aspro648/Arduino/README.md

# Arduino
DIY Clones done in KiCAD

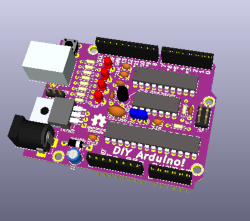
[picture p1: DIY Arduino/Arduino/images/project.png]
 
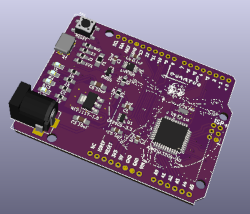
[picture p2: Leonardo/images/project.png]
 

- [Uno Compatible Through Hole](DIY%20Arduino/Arduino)
- [Leonardo Compatible Surface Mount](Leonardo/)
