aspro648/Arduino/DIY Arduino/20QFNtoDIP/project.png

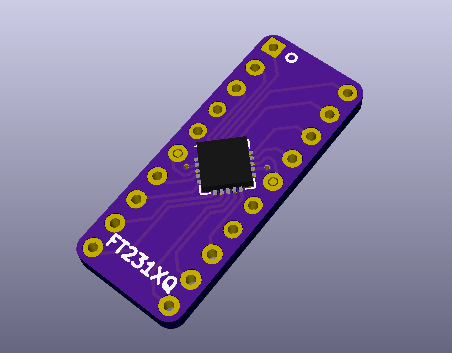
DIY Arduino/20QFNtoDIP/project.png
