aspro648/Arduino/DIY Arduino/Arduino/documents/DIYArduino Label.png

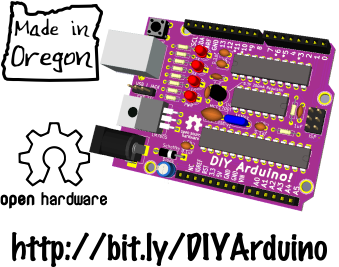
DIY Arduino/Arduino/documents/DIYArduino Label.png
