aspro648/Arduino/DIY Arduino/Arduino/images/2019-03-30T04_05_36.657Z-P1080907.JPG

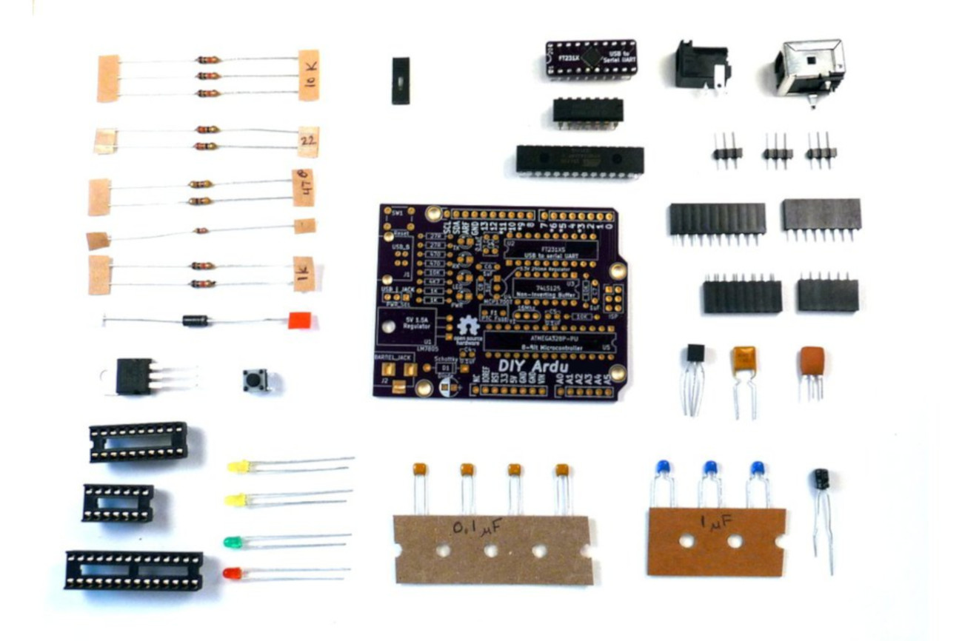
DIY Arduino/Arduino/images/2019-03-30T04_05_36.657Z-P1080907.JPG
