aspro648/Arduino/DIY Arduino/Arduino/images/Ardu.JPG

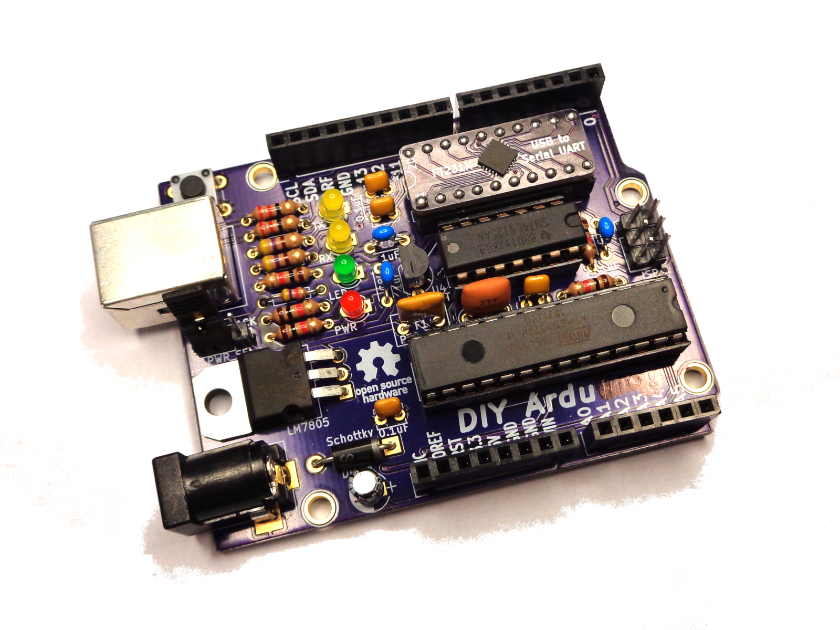
DIY Arduino/Arduino/images/Ardu.JPG
