aspro648/Arduino/DIY Arduino/Arduino/images/DIYArduino.png

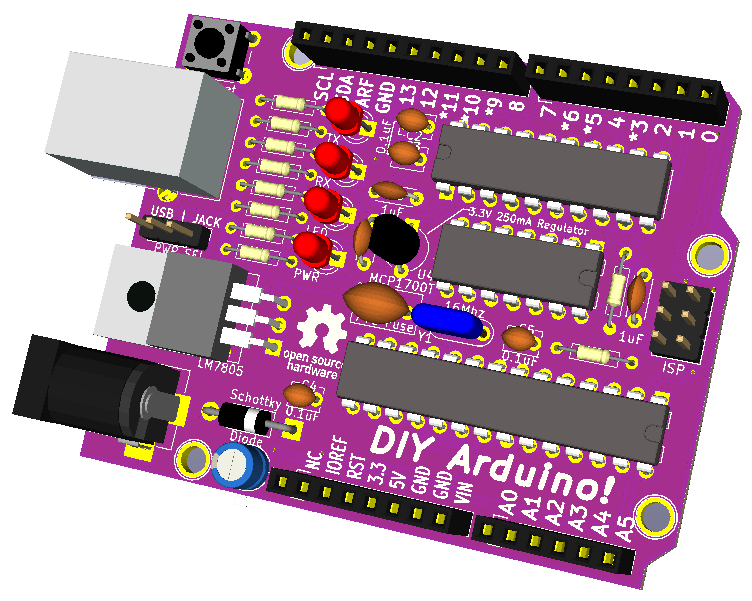
DIY Arduino/Arduino/images/DIYArduino.png
