aspro648/Arduino/Leonardo/documents/label.png

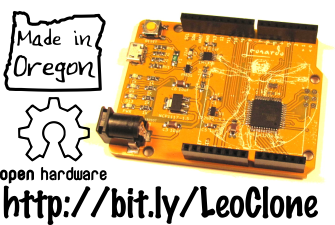
Leonardo/documents/label.png
