aspro648/Arduino/Leonardo/images/back.JPG

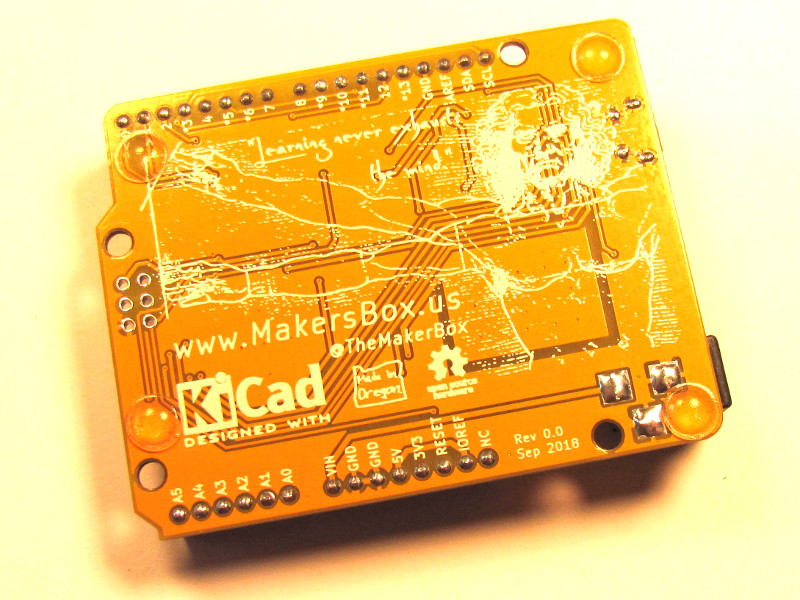
Leonardo/images/back.JPG
