aspro648/Arduino/Leonardo/images/Da_Vinci_Vitruve3.jpg

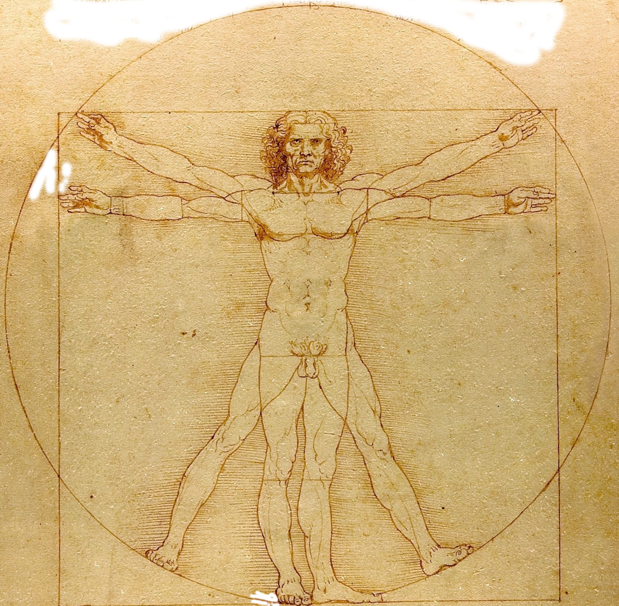
Leonardo/images/Da_Vinci_Vitruve3.jpg
