aspro648/Arduino/Leonardo/images/Da_Vinci_Vitruve_Luc_Viatour.jpg

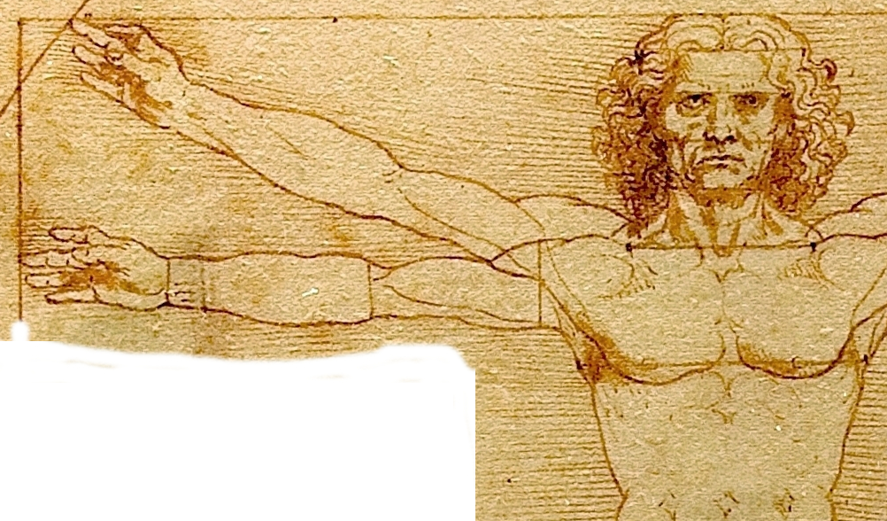
Leonardo/images/Da_Vinci_Vitruve_Luc_Viatour.jpg
