aspro648/Arduino/Leonardo/images/front.JPG

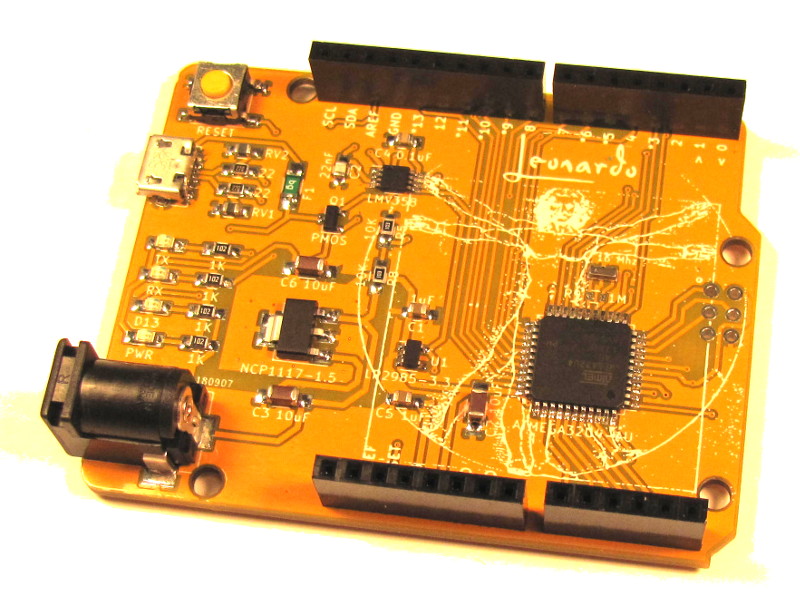
Leonardo/images/front.JPG
