aspro648/Arduino/Leonardo/images/IMG_0759.JPG

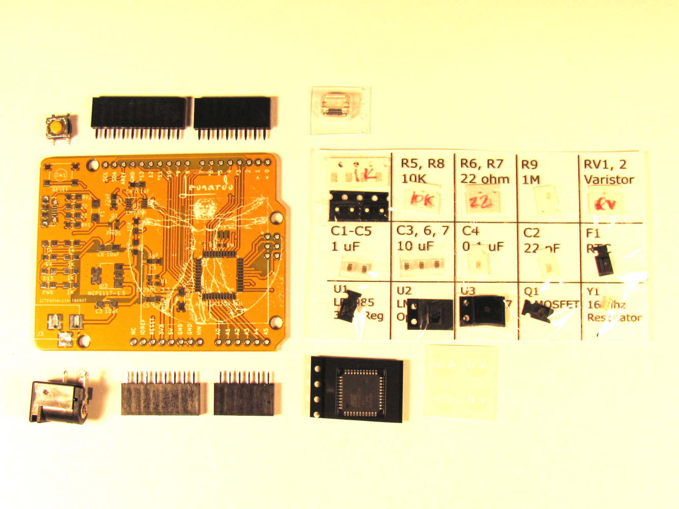
Leonardo/images/IMG_0759.JPG
