aspro648/Arduino/Leonardo/images/project_back.png

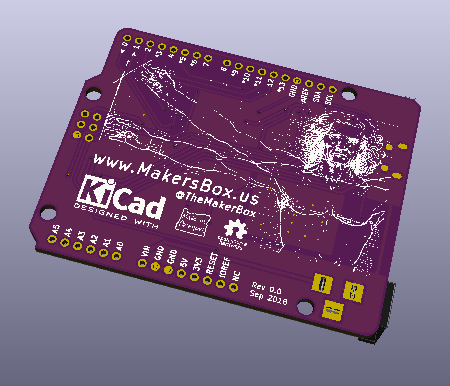
Leonardo/images/project_back.png
