aspro648/Arduino/Leonardo/images/quote.png

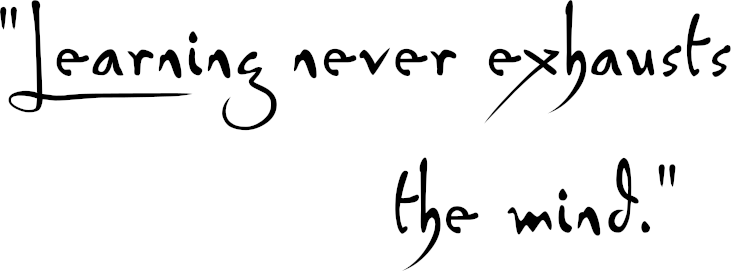
Leonardo/images/quote.png
