aspro648/Arduino/Leonardo/design_files/Bom.xlsx

Description | Manufacturer Part Number | Manufacturer | Digi-Key Part Number | Customer Reference | Quantity | $ at Qty 1 | $ at Qty 25 | Total @ Qty 1 | Tota @ Qty 25
PCB |  | OSH Park | - | - | 1 | $9.48 | $5.72 | $9.48 | $5.72 | ~$2.60 JLCPCB?
IC REG LINEAR 3.3V 150MA SOT23-5 | LP2985-33DBVRG4 | Texas Instruments | 296-49790-1-ND | Leo U1 | 1 | $0.60 | $0.53 | $0.60 | $0.53
IC OPAMP GP 1MHZ RRO 8VSSOP | LMV358IDGKR | Texas Instruments | 296-13455-1-ND | Leo U2 | 1 | $0.80 | $0.71 | $0.80 | $0.71
IC MCU 8BIT 32KB FLASH 44TQFP | ATMEGA32U4-AUR | Microchip Technology | ATMEGA32U4-AURCT-ND | Leo U4 | 1 | $4.20 | $3.85 | $4.20 | $3.85
IC REG LINEAR 5V 1A SOT223 | NCP1117ST50T3G | ON Semiconductor | NCP1117ST50T3GOSCT-ND | Leo U3 | 1 | $0.54 | $0.46 | $0.54 | $0.46
MOSFET P-CH 20V 2A SSOT3 | FDN340P | ON Semiconductor | FDN340PCT-ND | Leo Q1 | 1 | $0.55 | $0.43 | $0.55 | $0.43
CER RES 16.0000MHZ 15PF SMD | CSTCE16M0V53-R0 | Murata Electronics North America | 490-1198-1-ND | Leo Y1 | 1 | $0.50 | $0.42 | $0.50 | $0.42
CAP CER 10UF 35V X5R 1206 | GRM319R6YA106KA12D | Murata Electronics North America | 490-9964-1-ND | Leo C3, C6, C7 | 3 | $0.41 | $0.16 | $1.23 | $0.48
CAP CER 0.1UF 25V X7R 0805 | CC0805KRX7R8BB104 | Yageo | 311-1141-1-ND | Leo C4 | 1 | $0.13 | $0.10 | $0.13 | $0.10
CAP CER 22PF 25V C0G/NP0 0805 | 885012007030 | Wurth Electronics Inc. | 732-7829-1-ND | Leo C2 | 1 | $0.10 | $0.05 | $0.10 | $0.05
CAP CER 1UF 25V X5R 0805 | CL21A105KAFNNNE | Samsung Electro-Mechanics | 1276-2887-1-ND | Leo C1, C5 | 2 | $0.19 | $0.14 | $0.38 | $0.28
PTC RESET FUSE 24V 250MA 1206 | 0ZCJ0025AF2E | Bel Fuse Inc. | 507-1799-1-ND | Leo F1 | 1 | $0.13 | $0.13 | $0.13 | $0.13
VARISTOR 10.8V 40A 0805 | VCUG080050L1DP | AVX Corporation | 478-5584-1-ND | Leo RV1, RV2 | 2 | $0.49 | $0.36 | $0.98 | $0.72
RES SMD 1K OHM 5% 1/8W 0805 | ERJ-6GEYJ102V | Panasonic Electronic Components | P1.0KACT-ND | Leo R1 - R4 | 4 | $0.10 | $0.03 | $0.40 | $0.12
RES SMD 10K OHM 5% 1/8W 0805 | ERJ-6GEYJ103V | Panasonic Electronic Components | P10KACT-ND | Leo R5, R8 | 2 | $0.10 | $0.03 | $0.20 | $0.06
RES SMD 22 OHM 5% 0.4W 0805 | ESR10EZPJ220 | Rohm Semiconductor | RHM22KCT-ND | Leo R6, R7 | 2 | $0.10 | $0.03 | $0.20 | $0.06
CRGCQ 0603 1M0 5% | CRGCQ0603J1M0 | TE Connectivity Passive Product | A130109CT-ND | Leo R9 | 1 | $0.10 | $0.03 | $0.10 | $0.03
LED ORANGE CLEAR SMD | LTST-C170KFKT | Lite-On Inc. | 160-1413-1-ND | Leo D1-D4 | 4 | $0.31 | $0.12 | $1.24 | $0.48
SWITCH TACTILE SPST-NO 0.05A 24V | B3S-1002 | Omron Electronics Inc-EMC Div | SW416-ND | Leo SW1 | 1 | $0.66 | $0.62 | $0.66 | $0.62
CONN RCPT MICRO USB R/A SMD | 1050170001 | Molex, LLC | WM1399CT-ND | Leo X3 | 1 | $0.87 | $0.72 | $0.87 | $0.72
CONN PWR JACK 2X5.5MM SOLDER | PJ-002A | CUI Inc. | CP-002A-ND | Leo J1 | 1 | $0.61 | $0.52 | $0.61 | $0.52
CONN HEADER FEMALE 6POS .1" TIN | PPTC061LFBN-RC | Sullins Connector Solutions | S7004-ND | Leo | 1 | $0.52 | $0.48 | $0.52 | $0.48
CONN HEADER FEMALE 8POS .1" TIN | PPTC081LFBN-RC | Sullins Connector Solutions | S7006-ND | Leo | 2 | $0.65 | $0.61 | $1.30 | $1.22
CONN HEADER FEMALE 10POS.1" TIN | PPTC101LFBN-RC | Sullins Connector Solutions | S7008-ND | Leo | 1 | $0.65 | $0.57 | $0.65 | $0.57
 |  |  |  |  |  |  |  | $26.37 | $18.76
