aspro648/Arduino/DIY Arduino/Arduino/documents/NerO BOM List.xls

Sheet: Bill of Materials
Bill of Materials for: |  | Bill of Materials For Project HW_459_Long Pin |  |  |  |  | Future Technology Devices International Ltd.
 |  | Inspired by Arduino UNO R3 |  |  |  |  | Unit 1, 2 Seaward Place,
 |  |  |  |  |  |  | Centurion Business Park
 | Source Data From: | HW_459.PrjPcb |  |  |  |  | Glasgow, G411HH
 | Project: | HW_459.PrjPcb |  |  |  |  | Tel. +44 (0) 141 429 2777
 | Variant: | None |  |  |  |  | www.ftdichip.com
 | Revision: | 1.1
 | Report Date: | 4/1/2016 | 5:01:35 PM
# | Designator | Comment | Description | Footprint | Quantity | DigiKeyPartNo | ManufacturerPartNo | Manufacturer | Note
1 | C3, C4, C5, C7, C9, C11, C12, C14, C16, C19, C20, C21, C22 | 0.1UF | Capacitor bipolar | CAPC1608-0603 | 13 | 1276-1936-1-ND | CL10B104KB8SFNC | Samsung Electro-Mechanics America, Inc. | CAP CERAMIC .1UF 50V X7R 0603
2 | C6, C8, C13, C23 | 10uF | Polarized Capacitor | CAPM-A-3216-18 | 4 | 478-1657-1-ND | TAJA106M010RNJ | AVX Corporation | CAP TANT LOESR 10.0UF 10V 20% SMD 1206
3 | C10 | 10UF/25V | Polarized Capacitor | CAPM-B-3528-21 | 1 | 478-8887-1-ND | TAJB106M025RNJ | AVX Corporation | CAP TANT 10UF 25V 20% 1210
4 | C15 | 1NF | Capacitor bipolar | CAPC1608-0603 | 1 | 1276-1916-1-ND | CL10B102KB8SFNC | Samsung Electro-Mechanics America, Inc. | CAP 1000PF 50V CERAMIC X7R 0603
5 | C17, C18 | 15pF | Capacitor bipolar | CAPC1608-0603 | 2 | 1276-1296-1-ND | CL10C150JB8NNNC | Samsung Electro-Mechanics America, Inc. | CAP CER 15PF 50V 5% NPO 0603
6 | C24 | 10nF | Capacitor bipolar | CAPC1608-0603 | 1 | 1276-1927-1-ND | CL10B103MB8NCNC | Samsung Electro-Mechanics America, Inc. | CAP CER 10000PF 50V X7R 0603
7 | CN1 | CN USB | Mini USB connector; SMD | CN_USB_MICRO_HOUSING | 1 | --- | MIC5-5BF1-KNM1-23 | E-CONN ELECTRONIC(SU-ZHOU) CO., LTD | MICRO USB B REC. (HOUSEING HOLE)
8 | CN2 | 2.1mm PwrJack | Low Voltage Power Supply Connector | CN_2.1mm Power Socket routed pins | 1 | CP-002A-ND | PJ-002A | CUI Inc | CONN POWER JACK 2.1MM
9 | CN3 | TC2030-IDC-FP | ISP Connector, 6-Pin, Dual row, pitch 0.05"; Tag-Connect; TC2030-IDC-FP | CN_HDR2X3 | 1 | S2011E-03-ND | PBC03DAAN | Sullins Connector Solutions | CONN HEADER .100 DUAL STR 6POS
10 | CN4, CN7 | HEADER 8 | Header, 8-Pin | CN_HDR1X8 | 2 |  | FAS1851-0801A03XABXA | JunJia Electronics Technology | Connector Receptacle 8 Position 0.100" (2.54mm) Tin Through Hole
11 | CN5 | HEADER 10 | Header, 10-Pin | CN_HDR1X10 | 1 |  | FAS1851-1001A03XABXA | JunJia Electronics Technology | Connector Receptacle 10 Position 0.100" (2.54mm) Tin Through Hole
12 | CN6 | HEADER 6 | Header, 6-Pin | HDR1X6 | 1 |  | FAS1851-0601A03XABXA | JunJia Electronics Technology | Connector Receptacle 6 Position 0.100" (2.54mm) Tin Through Hole
13 | D1, D3 | MSS1P3L | Zener Diode | DIODE_MSS1P3L | 2 | MSS1P3L-M3/89AGICT-ND | MSS1P3L | VISHAY SEMICONDUCTOR | DIODE SCHOTTKY 30V 1A MICROSMP
14 | D2, D4 | 1N4148 | DIODE SWITCH 75V 200MW SOD323 | SOD-323 | 2 | 1N4148WS-FDICT-ND | 1N4148WS-7-F | Diodes Inc | DIODE SWITCH 75V 200MW SOD323
15 | F1 | 1.1A | Fuse | Fuse_0ZCG Series | 1 | 507-1767-1-ND | 0ZCG0110AF2C | Bel Fuse Inc | PTC RESTTBLE 1.10A 16V CHIP 1812
16 | FB1, FB2 | 600R/2A | Chip Ferrite Bead 0805 | IND_C2012-0805 | 2 | 445-2206-1-ND | MPZ2012S601A | TDK Corporation | FERRITE CHIP 600 OHM 2A 0805
17 | L1 | 22UH | Magnetic-Core Inductor | IND_NR6020 | 1 | 587-2103-1-ND | NR6028T220M | TAIYO YUDEN | IND 22UH 1.4A +-20% 6X6X2.8MM
18 | PCB | HW_459 Rev1.1 Bare PCB |  |  | 1 |  |  |  | HW_459 Rev1.1 Bare PCB
19 | PWR | Green | Typical LED diode | LEDC2012-0805 | 1 | 160-1179-1-ND | LTST-C170GKT | Lite-On Inc | LED GREEN CLEAR 0805 SMD
20 | Q1, Q2 | IRLM6402PBF | P-Channel MOSFET; SOT-23 | SOT23-3AL | 2 | IRLML6402PBFCT-ND | IRLML6402TRPBF | International Rectifier | MOSFET P-CH 20V 3.7A SOT-23
21 | R1, R2 | 27R | Resistor | RESC1608-0603 | 2 |  | 0603WGF0270 | UniOhm | RES 27R OHM 1/16W 1% 0603 SMD
22 | R3, R4 | 470R | Resistor | RESC1608-0603 | 2 |  | 0603WGJ0471 | UniOhm | RES 470 OHM 5% 1/16W 0603 SMD
23 | R6, R7, R15, R22 | 1K | Resistor | RESC1608-0603 | 4 |  | 0603WGJ0102 | UniOhm | RES 1K OHM 1/16W 5% 0603 SMD
24 | R9, R12, R13, R19 | 47K | Resistor | RESC1608-0603 | 4 |  | 0603WGJ0473 | UniOhm | RES 47K OHM 1/16W 5% 0603 SMD
25 | R10 | 47K5 | Resistor | RESC1608-0603 | 1 |  | 0603WGF4752 | UniOhm | RES 47K5 OHM 1/16W 1% 0603 SMD
26 | R11 | 9K1 | Resistor | RESC1608-0603 | 1 |  | 0603WGF0912 | UniOhm | RES 9K1 OHM 1% 1/16W 0603 SMD
27 | R14, R21, R23 | 10K | Resistor | RESC1608-0603 | 3 |  | 0603WGF0103 | UniOhm | RES 10K OHM 1/16W 1% 0603 SMD
28 | R17 | 0R | Resistor | RESC1608-0603 | 1 |  | 0603WAF0000XXX | UniOhm | RES 0 OHM 1/16W 0603 SMD
29 | R20 | 4K7 | Resistor | RESC1608-0603 | 1 |  | 0603WGF0472 | UniOhm | RES 4K7 OHM 1% 1/16W 0603 SMD
30 | RX, TX | Yellow | Typical LED diode | LEDC2012-0805 | 2 | 160-1175-1-ND | LTST-C170YKT | Lite-On Inc | LED YELLOW CLEAR 0805 SMD
31 | SCK | Red | Typical LED diode | LEDC2012-0805 | 1 | L61101CT-ND | 7012X1 | Chicago Miniature Lighting, LLC | LED RED CLEAR 0805 SMD
32 | SW1 | SW-DPDT | SPDT Switch | SW_JS202011AQN | 1 | 401-2000-ND | JS202011AQN | C&K Components | SWITCH SLIDE DPDT 300MA 6V
33 | SW2 | SW_PB | Push button momentary switch | SW_PushButton | 1 | 450-1650-ND | 1825910-6 | TE Connectivity Alcoswitch Switches | SWITCH TACTILE SPST-NO 0.05A 24V
34 | U1 | FT231XS | FT231XS-SSOP-20 | SSOP20 | 1 | 768-1129-1-ND | FT231XS-R | FTDI chip | IC USB SERIAL FULL UART 20SSOP
35 | U2, U6, U7 | CAHCT1G125QDCKRQ1 | IC BUS BUFF GATE 3ST SGL SC70-5 | SC70-5 | 3 | 296-29588-1-ND | CAHCT1G125QDCKRQ1 | Texas Instruments | Do not change to other vendor
36 | U3 | SPX3819M5-L-3-3/TR | 500mA, Low Dropout Linear Regulator with Shutdown | SOT23-5AL | 1 | 1016-1873-1-ND | SPX3819M5-L-3-3/TR | Exar Corporation | IC REG LDO 3.3V 0.5A SOT23-5
37 | U4 | AOZ1282CI | IC REG BUCK ADJ 1.2A SOT23-6 | SOT23-6N | 1 | 785-1613-1-ND | AOZ1282CI | ALPHA&OMEGA SEMICONDUCTOR | IC REG BUCK ADJ 1.2A SOT23-6
38 | U5 | ATMEGA328P-AU | IC MCU 8BIT 32KB FLASH 32TQFP | TQFP80P900X900X160-32N | 1 | ATMEGA328P-AURCT-ND | ATMEGA328P-AU | ATMEL | IC MCU 8BIT 32KB FLASH 32TQFP
39 | X1 | 16MHZ | Crystal Oscillator | CRYSTAL_16MHZ | 1 | 490-1198-1-ND | CSTCE16M0V53-R0 | Murata Electronic | CER RESONATOR 16.0MHZ SMD
Notes: |  |  |  | Components Count: | 73

Sheet: Project Information
Project Full Path | Z:\Hardware\PCB Designs\HW_459_NerO\Rev 1.1\HW_459.PrjPcb
Project Filename | HW_459.PrjPcb
Variant Name | None
Data-Source Filename | HW_459.PrjPcb
Data-Source Full Path | Z:\Hardware\PCB Designs\HW_459_NerO\Rev 1.1\HW_459.PrjPcb
Title | Bill of Materials For Project [HW_459.PrjPcb] (No PCB Document Selected)
Total Quantity | 73
Report Time | 5:01:35 PM
Report Date | 4/1/2016
Report Date & Tine | 4/1/2016 5:01:35 PM
Output Name | Bill of Materials
Output Type | BOM_PartType
Output Generator Name | BOM
Output Generator Description | Bill of Materials
