aspro648/Arduino/Leonardo/documents/parts.png

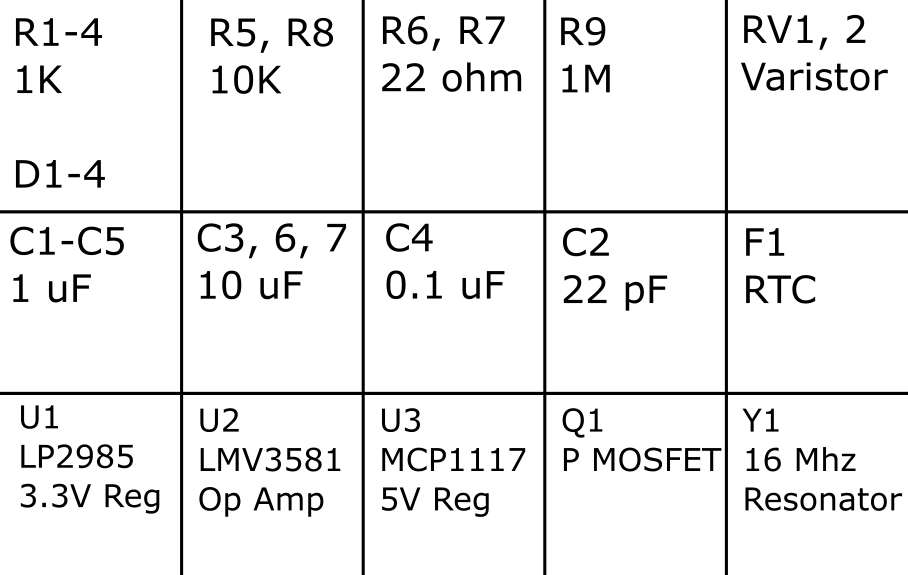
Leonardo/documents/parts.png
