aspro648/Arduino/DIY Arduino/Arduino/design_files/Arduino.kicad_pcb

## KiCad design DIY Arduino/Arduino/design_files/Arduino.kicad_pcb (2020-08-26)

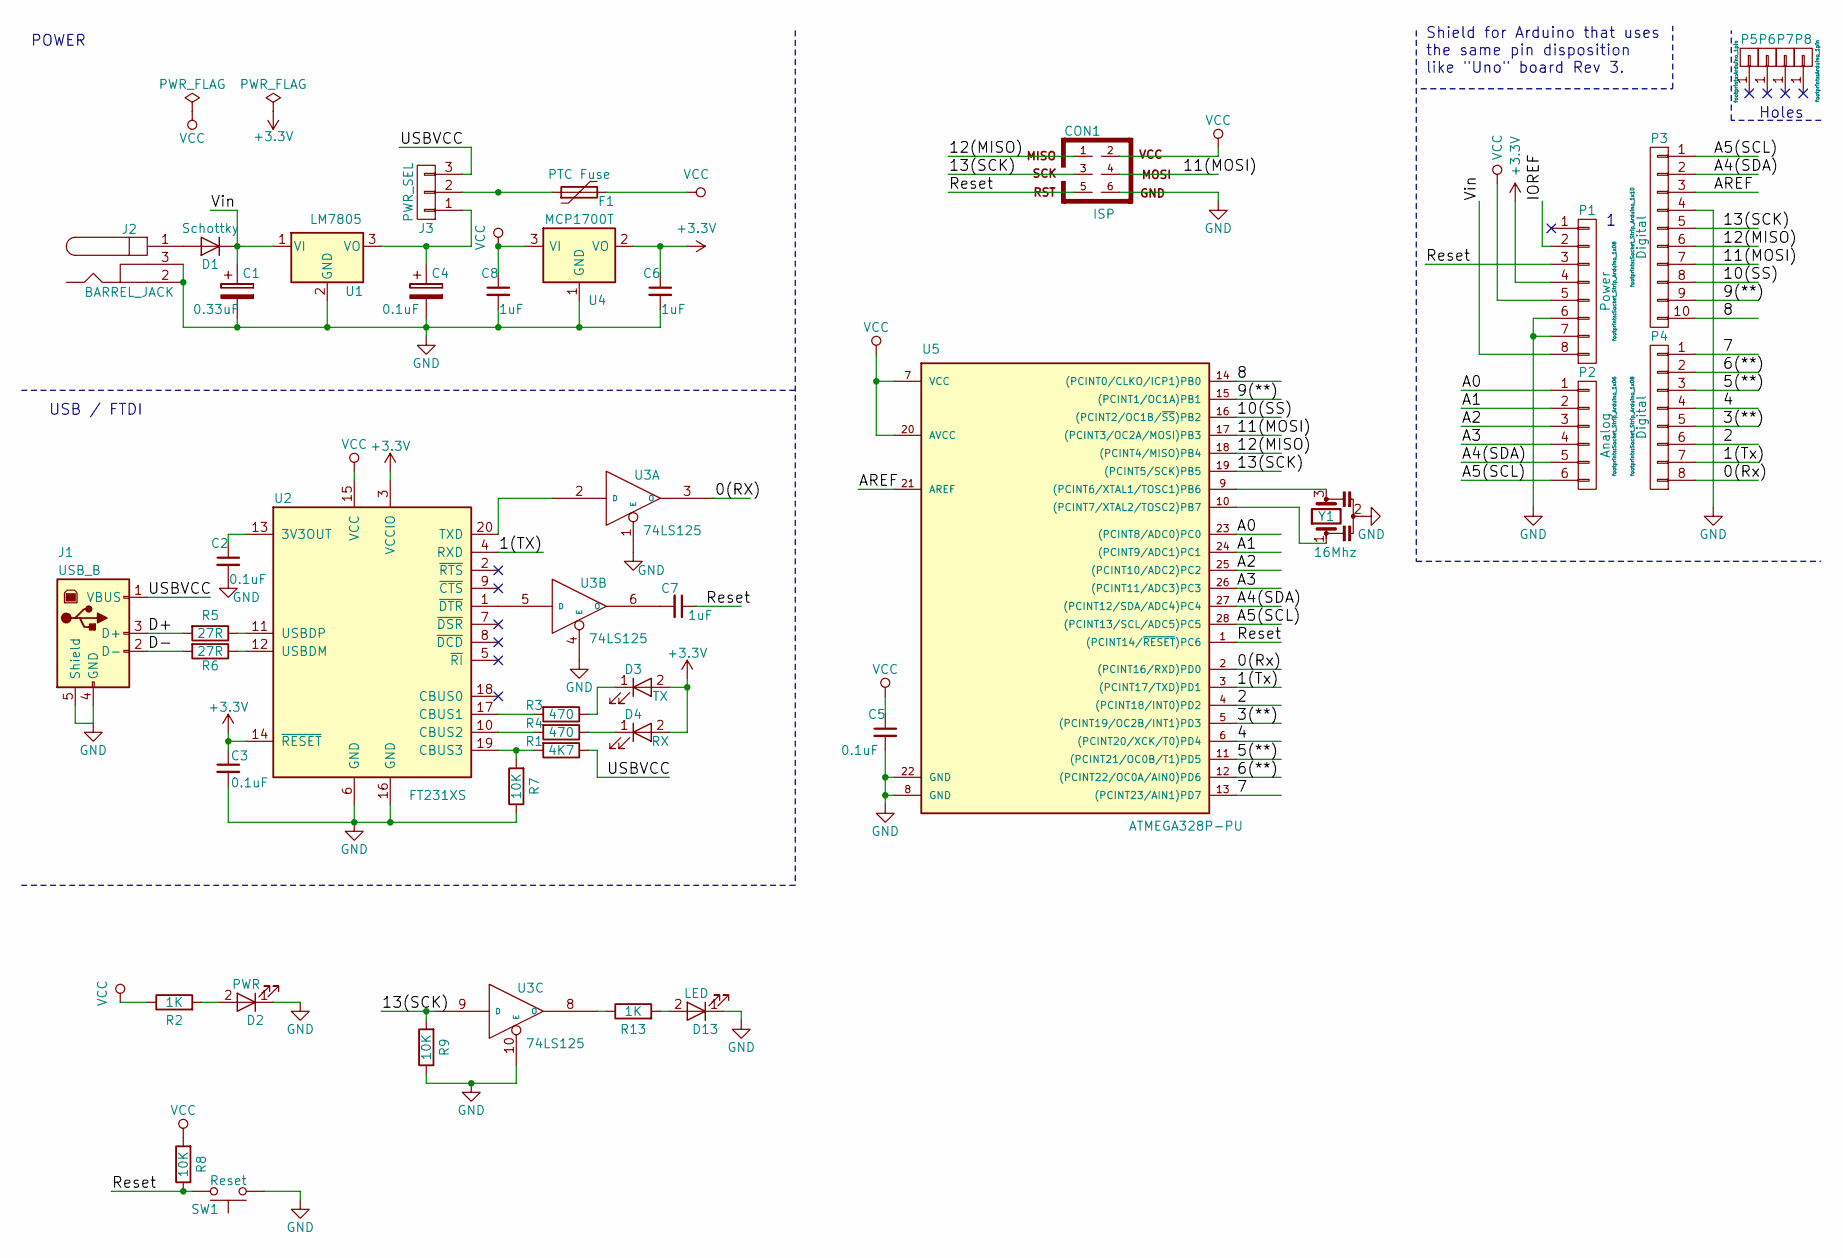
[picture p17: schematic Arduino.sch, DIY Arduino]

Parts:
C1: 0.33uF; CP_Radial_D4.0mm_P1.50mm
C2, C3, C4, C5: 0.1uF; C_Disc_D3.8mm_W2.6mm_P2.50mm
C6, C7, C8: 1uF; C_Disc_D4.3mm_W1.9mm_P5.00mm
CON1: ISP; Pin_Header_Straight_2x03_Pitch2.54mm
D1: Schottky; D_DO-41_SOD81_P10.16mm_Horizontal
D2: PWR; LED_D3.0mm
D3: TX; LED_D3.0mm
D4: RX; LED_D3.0mm
D13: LED; LED_D3.0mm
F1: PTC Fuse; C_Disc_D7.5mm_W4.4mm_P5.00mm
J1: USB_B
J2: BARREL_JACK
J3: PWR_SEL; Pin_Header_Straight_1x03_Pitch2.54mm
P1: Power; Socket_Strip_Arduino_1x08
P2: Analog; Socket_Strip_Arduino_1x06
P3: Digital; Socket_Strip_Arduino_1x10
P4: Digital; Socket_Strip_Arduino_1x08
P5, P6, P7, P8: CONN_01X01; Arduino_1pin
R1: 4K7; R_Axial_DIN0204_L3.6mm_D1.6mm_P7.62mm_Horizontal
R2, R13: 1K; R_Axial_DIN0204_L3.6mm_D1.6mm_P7.62mm_Horizontal
R3, R4: 470; R_Axial_DIN0204_L3.6mm_D1.6mm_P7.62mm_Horizontal
R5, R6: 27R; R_Axial_DIN0204_L3.6mm_D1.6mm_P7.62mm_Horizontal
R7, R8, R9: 10K; R_Axial_DIN0204_L3.6mm_D1.6mm_P7.62mm_Horizontal
SW1: Reset; SW_PUSH_6mm
U1: LM7805; TO-220-3_Horizontal
U2: FT231XS; DIP-20_W7.62mm
U3: 74LS125; DIP-14_W7.62mm
U4: MCP1700T; TO-92_Inline_Wide
U5: ATMEGA328P-PU; DIP-28_W7.62mm
Y1: 16Mhz; Resonator-3pin_w7.0mm_h2.5mm

Connections:
+3V3: C3.1, C6.1, D3.2 (A), D4.2 (A), P1.4, U2.3 (VCCIO), U2.14 (~RESET), U4.2 (VO)
/0(RX): P4.8, U3.3 (O), U5.2 ((PCINT16/RXD)PD0)
/1(TX): P4.7, U2.4 (RXD), U5.3 ((PCINT17/TXD)PD1)
/2: P4.6, U5.4 ((PCINT18/INT0)PD2)
/3(**): P4.5, U5.5 ((PCINT19/OC2B/INT1)PD3)
/4: P4.4, U5.6 ((PCINT20/XCK/T0)PD4)
/5(**): P4.3, U5.11 ((PCINT21/OC0B/T1)PD5)
/6(**): P4.2, U5.12 ((PCINT22/OC0A/AIN0)PD6)
/7: P4.1, U5.13 ((PCINT23/AIN1)PD7)
/8: P3.10, U5.14 ((PCINT0/CLKO/ICP1)PB0)
/9(**): P3.9, U5.15 ((PCINT1/OC1A)PB1)
/10(SS): P3.8, U5.16 ((PCINT2/OC1B/~SS~)PB2)
/11(MOSI): CON1.4, P3.7, U5.17 ((PCINT3/OC2A/MOSI)PB3)
/12(MISO): CON1.1, P3.6, U5.18 ((PCINT4/MISO)PB4)
/13(SCK): CON1.3, P3.5, R9.2, U3.9 (D), U5.19 ((PCINT5/SCK)PB5)
/A0: P2.1, U5.23 ((PCINT8/ADC0)PC0)
/A1: P2.2, U5.24 ((PCINT9/ADC1)PC1)
/A2: P2.3, U5.25 ((PCINT10/ADC2)PC2)
/A3: P2.4, U5.26 ((PCINT11/ADC3)PC3)
/A4(SDA): P2.5, P3.2, U5.27 ((PCINT12/SDA/ADC4)PC4)
/A5(SCL): P2.6, P3.1, U5.28 ((PCINT13/SCL/ADC5)PC5)
/AREF: P3.3, U5.21 (AREF)
/D+: J1.3 (D+), R5.2
/D-: J1.2 (D-), R6.2
/IOREF: P1.2
/Reset: C7.1, CON1.5, P1.3, R8.1, SW1.2, U5.1 ((PCINT14/~RESET~)PC6)
/USBVCC: J1.1 (VBUS), J3.3, R1.1
/Vin: C1.1, D1.1 (K), P1.8, U1.1 (VI)
GND: C1.2, C2.2, C3.2, C4.2, C5.2, C6.2, C8.2, CON1.6, D2.1 (K), D13.1 (K), J1.4 (GND), J1.5 (Shield), J2.2, J2.3, P1.6, P1.7, P3.4, R7.1, R9.1, SW1.1, U1.2 (GND), U2.6 (GND), U2.16 (GND), U3.1 (E), U3.4 (E), U3.7 (GND), U3.10 (E), U4.1 (GND), U5.8 (GND), U5.22 (GND), Y1.2
unnamed: C2.1, U2.13 (3V3OUT)
unnamed: C4.1, J3.1, U1.3 (VO)
unnamed: C7.2, U3.6 (O)
unnamed: D1.2 (A), J2.1
unnamed: D2.2 (A), R2.2
unnamed: D3.1 (K), R3.1
unnamed: D4.1 (K), R4.1
unnamed: D13.2 (A), R13.2
unnamed: F1.1, J3.2
unnamed: R1.2, R7.2, U2.19 (CBUS3)
unnamed: R3.2, U2.17 (CBUS1)
unnamed: R4.2, U2.10 (CBUS2)
unnamed: R5.1, U2.11 (USBDP)
unnamed: R6.1, U2.12 (USBDM)
unnamed: R13.1, U3.8 (O)
unnamed: U2.1 (~DTR), U3.5 (D)
unnamed: U2.20 (TXD), U3.2 (D)
unnamed: U5.9 ((PCINT6/XTAL1/TOSC1)PB6), Y1.3
unnamed: U5.10 ((PCINT7/XTAL2/TOSC2)PB7), Y1.1
VCC: C5.1, C8.1, CON1.2, F1.2, P1.5, R2.1, R8.2, U2.15 (VCC), U3.14 (VCC), U4.3 (VI), U5.7 (VCC), U5.20 (AVCC)

Notes on the sheet:
Holes
Shield for Arduino that uses the same pin disposition like "Uno" board Rev 3.
POWER
USB / FTDI

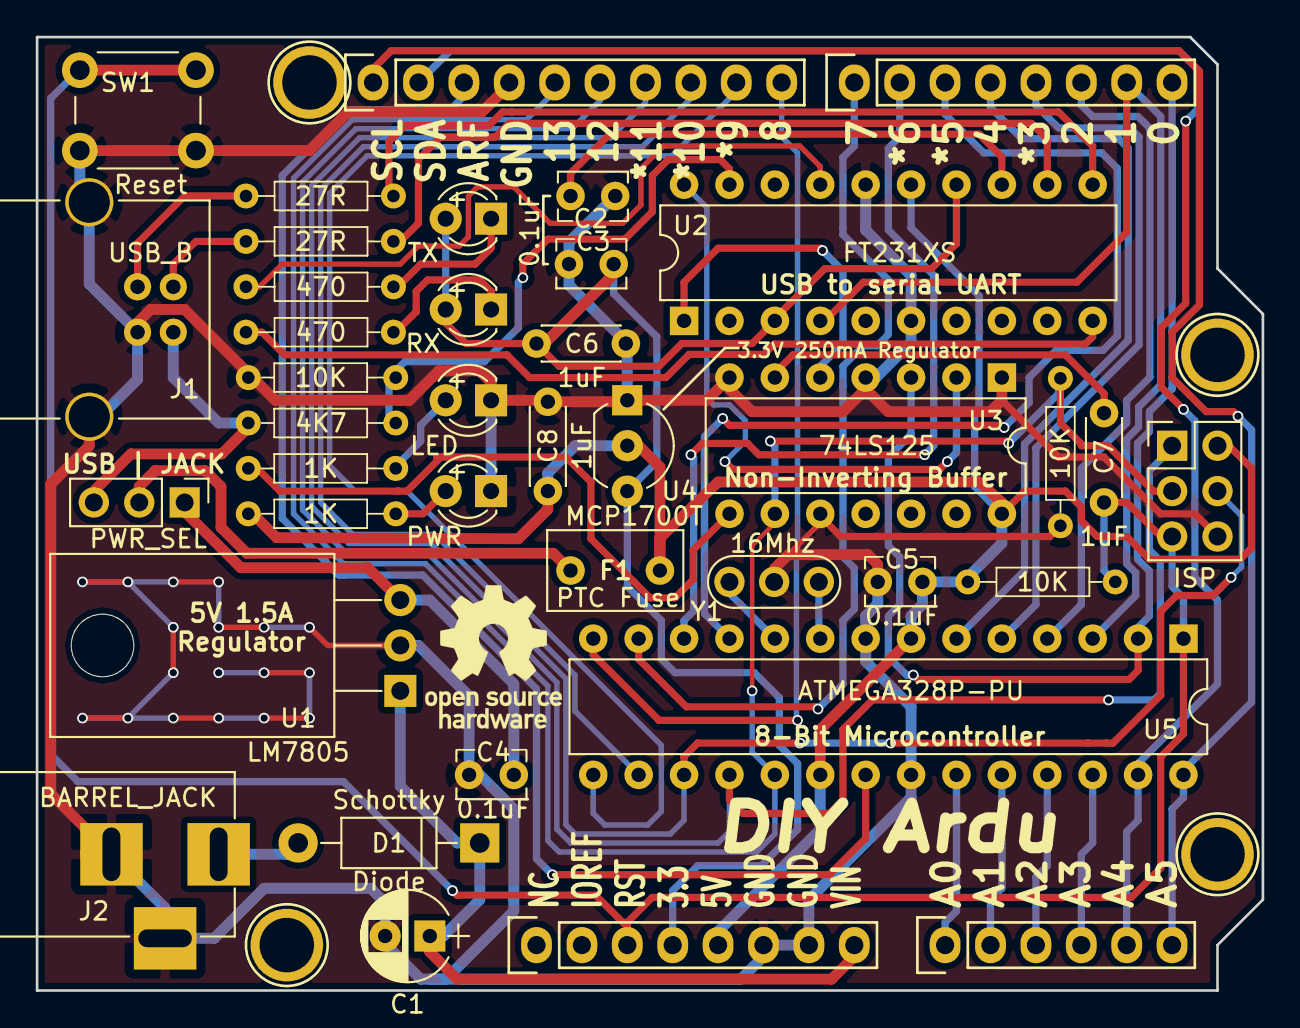
[picture p18: board Arduino.kicad_pcb from above]

Board: 2 copper layers, 68.6 x 53.3 mm, 43 parts (0 on the bottom side), 48 nets.
