aspro648/Arduino/Leonardo/design_files/project.kicad_pcb

## KiCad design Leonardo/design_files/project.kicad_pcb (2018-10-31)

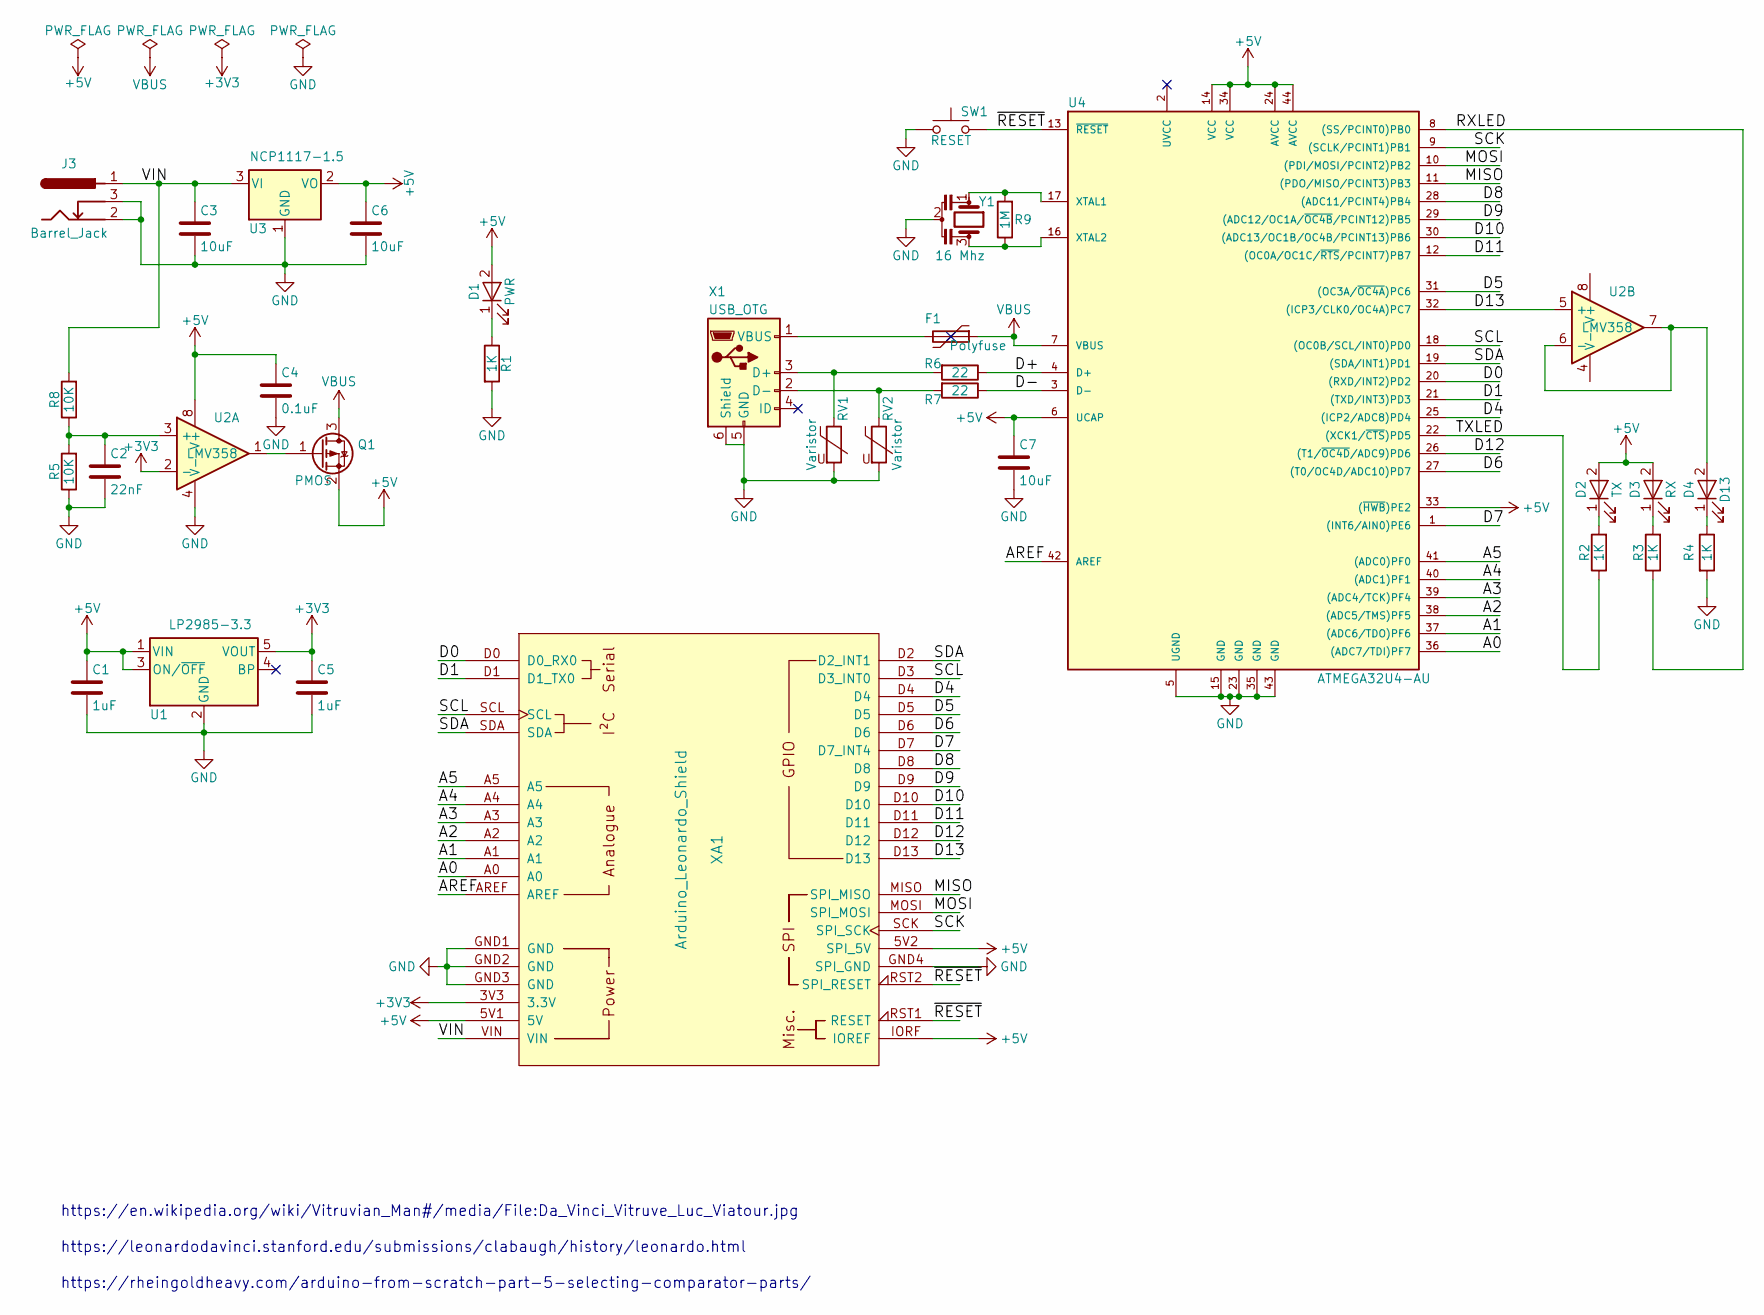
[picture p19: schematic project.sch, Leonardo 324U]

Parts:
C1, C5: 1uF; C_0805_HandSoldering
C2: 22nF; C_0805_HandSoldering
C3, C6, C7: 10uF; C_1206_HandSoldering
C4: 0.1uF; C_0805_HandSoldering
D1: PWR; LED_0805_HandSoldering
D2: TX; LED_0805_HandSoldering
D3: RX; LED_0805_HandSoldering
D4: D13; LED_0805_HandSoldering
F1: Polyfuse; R_1206_HandSoldering
J3: Barrel_Jack; BARREL_JACK
Q1: PMOS; SOT-23
R1, R2, R3, R4: 1K; R_0805_HandSoldering
R5, R8: 10K; R_0805_HandSoldering
R6, R7: 22; R_0805_HandSoldering
R9: 1M; R_0805_HandSoldering
RV1, RV2: Varistor; R_0805_HandSoldering
SW1: RESET; SW_SPST_PTS645
U1: LP2985-3.3; SOT-23-5
U2: LMV358; VSSOP-8_3.0x3.0mm_Pitch0.65mm
U3: NCP1117-1.5; SOT-223-3_TabPin2
U4: ATMEGA32U4-AU; TQFP-44_10x10mm_Pitch0.8mm
X1: USB_OTG; USB_Micro-B_Molex-105017-0001
XA1: Arduino_Leonardo_Shield
Y1: 16 Mhz; Resonator_SMD_CTSC_1.3mmx3.2mm

Connections:
+3V3: C5.1, U1.5 (VOUT), U2.2 (-), XA1.3V3 (3.3V)
+5V: C1.1, C4.1, C6.1, C7.1, D1.2 (A), D2.2 (A), D3.2 (A), Q1.2 (S), U1.1 (VIN), U1.3 (ON/~OFF~), U2.8 (V+), U3.2 (VO), U4.6 (UCAP), U4.14 (VCC), U4.24 (AVCC), U4.33 ((~HWB~)PE2), U4.34 (VCC), U4.44 (AVCC), XA1.5V1 (5V), XA1.5V2 (SPI_5V), XA1.IORF (IOREF)
/A0: U4.36 ((ADC7/TDI)PF7), XA1.A0
/A1: U4.37 ((ADC6/TDO)PF6), XA1.A1
/A2: U4.38 ((ADC5/TMS)PF5), XA1.A2
/A3: U4.39 ((ADC4/TCK)PF4), XA1.A3
/A4: U4.40 ((ADC1)PF1), XA1.A4
/A5: U4.41 ((ADC0)PF0), XA1.A5
/AREF: U4.42 (AREF), XA1.AREF
/D0: U4.20 ((RXD/INT2)PD2), XA1.D0 (D0_RX0)
/D1: U4.21 ((TXD/INT3)PD3), XA1.D1 (D1_TX0)
/D4: U4.25 ((ICP2/ADC8)PD4), XA1.D4
/D5: U4.31 ((OC3A/~OC4A~)PC6), XA1.D5
/D6: U4.27 ((T0/OC4D/ADC10)PD7), XA1.D6
/D7: U4.1 ((INT6/AIN0)PE6), XA1.D7 (D7_INT4)
/D8: U4.28 ((ADC11/PCINT4)PB4), XA1.D8
/D9: U4.29 ((ADC12/OC1A/~OC4B~/PCINT12)PB5), XA1.D9
/D10: U4.30 ((ADC13/OC1B/OC4B/PCINT13)PB6), XA1.D10
/D11: U4.12 ((OC0A/OC1C/~RTS~/PCINT7)PB7), XA1.D11
/D12: U4.26 ((T1/~OC4D~/ADC9)PD6), XA1.D12
/D13: U2.5 (+), U4.32 ((ICP3/CLK0/OC4A)PC7), XA1.D13
/D+: R6.1, U4.4 (D+)
/D-: R7.1, U4.3 (D-)
/MISO: U4.11 ((PDO/MISO/PCINT3)PB3), XA1.MISO (SPI_MISO)
/MOSI: U4.10 ((PDI/MOSI/PCINT2)PB2), XA1.MOSI (SPI_MOSI)
/RXLED: R3.1, U4.8 ((SS/PCINT0)PB0)
/SCK: U4.9 ((SCLK/PCINT1)PB1), XA1.SCK (SPI_SCK)
/SCL: U4.18 ((OC0B/SCL/INT0)PD0), XA1.D3 (D3_INT0), XA1.SCL
/SDA: U4.19 ((SDA/INT1)PD1), XA1.D2 (D2_INT1), XA1.SDA
/TXLED: R2.1, U4.22 ((XCK1/~CTS~)PD5)
/VIN: C3.1, J3.1, R8.2, U3.3 (VI), XA1.VIN
/~RESET: SW1.2, U4.13 (~RESET~), XA1.RST1 (RESET), XA1.RST2 (SPI_RESET)
GND: C1.2, C2.2, C3.2, C4.2, C5.2, C6.2, C7.2, J3.2, J3.3, R1.2, R4.2, R5.1, RV1.2, RV2.2, SW1.1, U1.2 (GND), U2.4 (V-), U3.1 (GND), U4.5 (UGND), U4.15 (GND), U4.23 (GND), U4.35 (GND), U4.43 (GND), X1.5 (GND), X1.6 (Shield), XA1.GND1 (GND), XA1.GND2 (GND), XA1.GND3 (GND), XA1.GND4 (SPI_GND), Y1.2
unnamed: C2.1, R5.2, R8.1, U2.3 (+)
unnamed: D1.1 (K), R1.1
unnamed: D2.1 (K), R2.2
unnamed: D3.1 (K), R3.2
unnamed: D4.1 (K), R4.1
unnamed: D4.2 (A), U2.6 (-), U2.7
unnamed: F1.2, X1.1 (VBUS)
unnamed: Q1.1 (G), U2.1
unnamed: R6.2, RV1.1, X1.3 (D+)
unnamed: R7.2, RV2.1, X1.2 (D-)
unnamed: R9.1, U4.16 (XTAL2), Y1.3
unnamed: R9.2, U4.17 (XTAL1), Y1.1
VBUS: F1.1, Q1.3 (D), U4.7 (VBUS)

Notes on the sheet:
https://rheingoldheavy.com/arduino-from-scratch-part-5-selecting-comparator-parts/
https://leonardodavinci.stanford.edu/submissions/clabaugh/history/leonardo.html
https://en.wikipedia.org/wiki/Vitruvian_Man#/media/File:Da_Vinci_Vitruve_Luc_Viatour.jpg

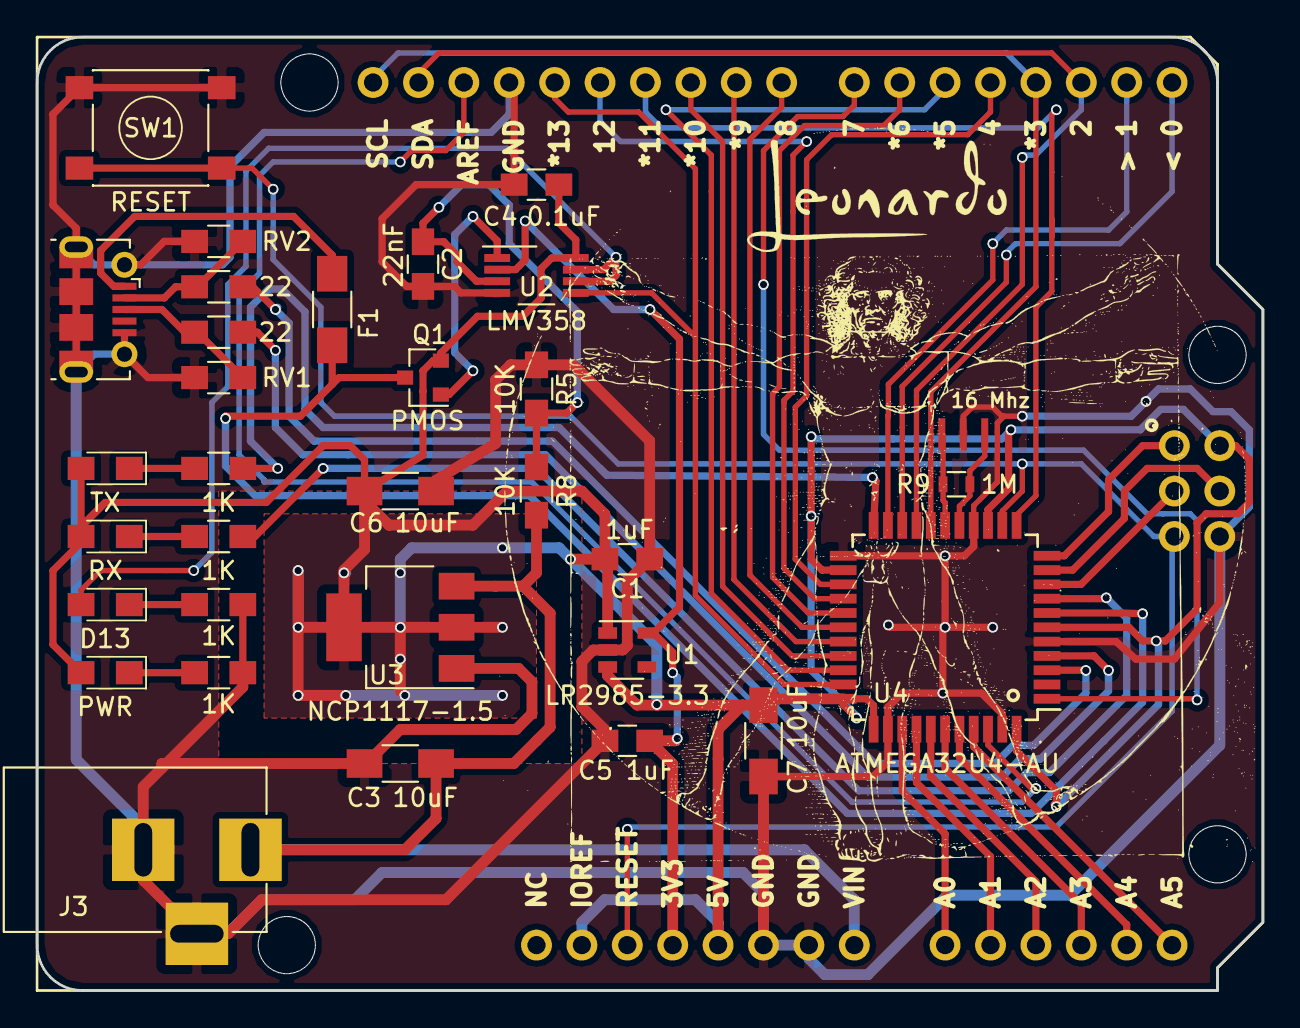
[picture p20: board project.kicad_pcb from above]

Board: 2 copper layers, 68.6 x 53.3 mm, 34 parts (0 on the bottom side), 46 nets.

Other parts of the board:
VAL: MadeInOregonRev25
