aspro648/Arduino/Leonardo/design_files/mask.kicad_pcb

## KiCad design Leonardo/design_files/mask.kicad_pcb (2018-10-28)

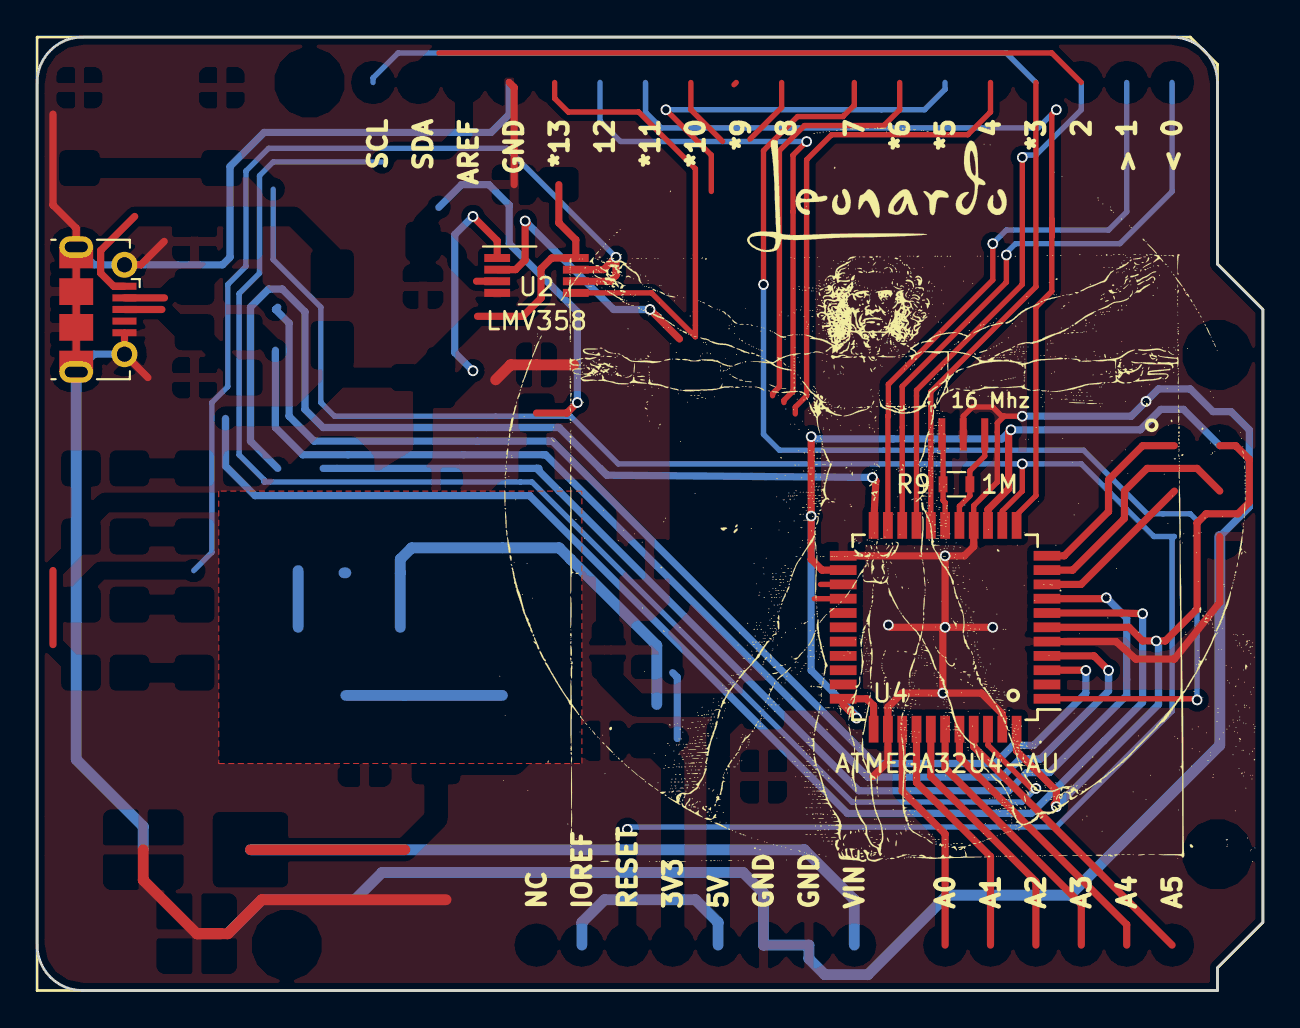
[picture p21: board mask.kicad_pcb from above]

Board: 2 copper layers, 68.6 x 53.3 mm, 6 parts (0 on the bottom side), 6 nets.

Parts:
R9: 1M; R_0603
U2: LMV358; VSSOP-8_3.0x3.0mm_Pitch0.65mm
U4: ATMEGA32U4-AU; TQFP-44_10x10mm_Pitch0.8mm
X1: USB_OTG; USB_Micro-B_Molex-105017-0001
XA1: Arduino_Leonardo_Shield
Y1: 16 Mhz; Resonator_SMD_CTSC_1.3mmx3.2mm

Connections:
+5V: U2.8, U4.6, U4.14, U4.24, U4.33, U4.34, U4.44
/D13: U2.5, U4.32
GND: U2.4, U4.5, U4.15, U4.23, U4.35, U4.43, X1.5, X1.6, Y1.2
unnamed: U2.6, U2.7
unnamed: R9.1, U4.16, Y1.3
unnamed: R9.2, U4.17, Y1.1
