aspro648/Arduino/(commit log)

2018-10-28 Initial upload
    [Arduino.kicad_pcb, Arduino.sch, NerO BOM List.xls, project.kicad_pcb, project.sch]
2018-10-28 Updating Leonardo
    [Bom.xlsx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]
2018-10-31 Minor footprint tweaks
    [project.kicad_pcb]
